mpmumau/Peabot-Library/3d_models/pibot_top.stl

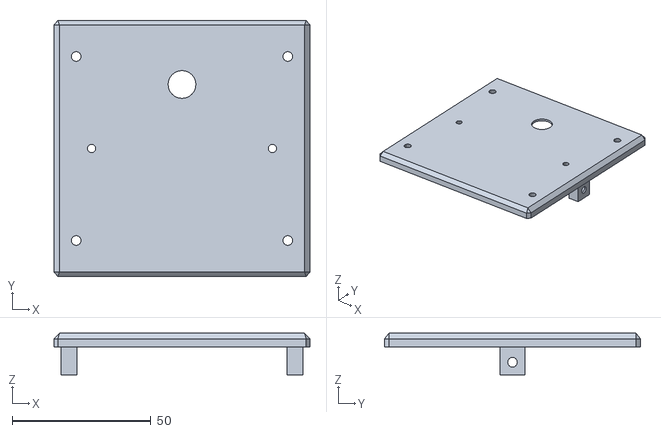
[picture p5: CAD file, 2017-05-08]
3d_models/pibot_top.stl
92.3 x 92.3 x 15.0
