mpmumau/Peabot-Library/3d_models/pibot_battery_holder_w_supports.stl

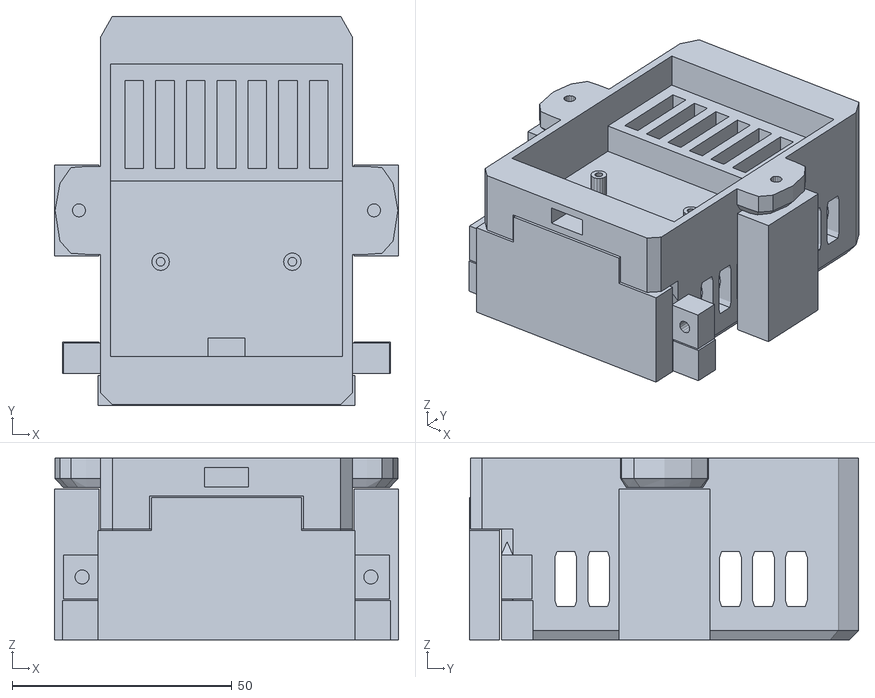
[picture p6: CAD file, 2017-05-08]
3d_models/pibot_battery_holder_w_supports.stl
78.3 x 88.6 x 41.4
