mpmumau/Peabot-Library/3d_models/pibot_battery_holder_face.stl

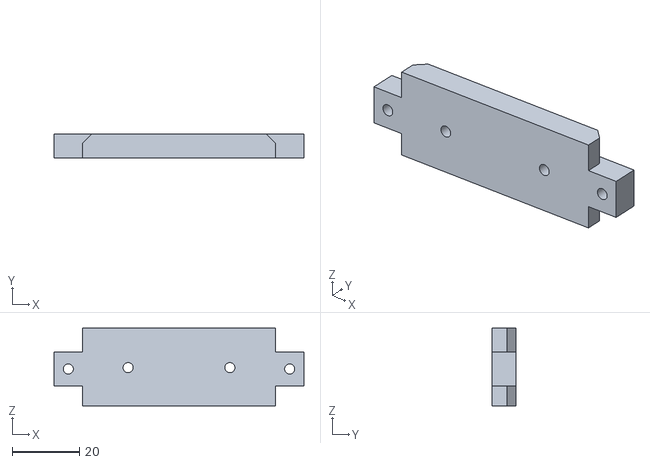
[picture p7: CAD file, 2017-05-08]
3d_models/pibot_battery_holder_face.stl
74.3 x 7.00 x 23.1
