mpmumau/Peabot-Library/3d_models/pibot_body.stl

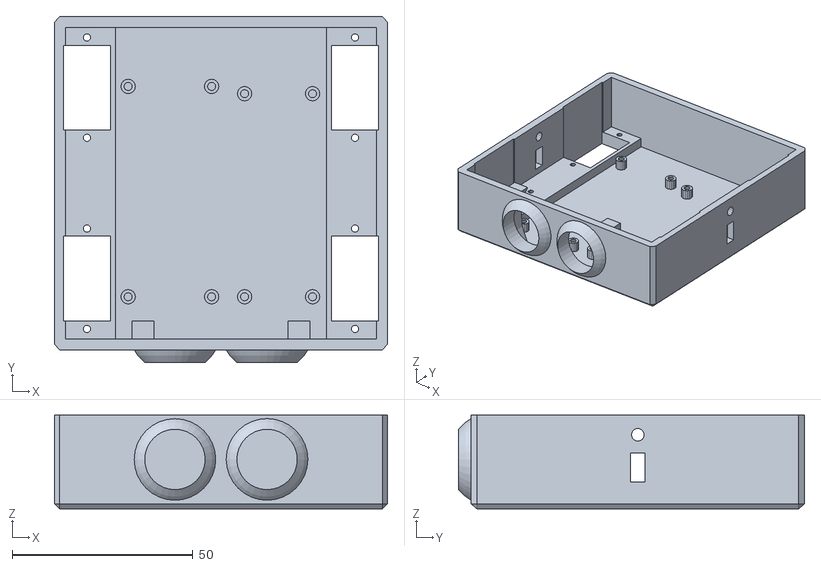
[picture p8: CAD file, 2017-05-08]
3d_models/pibot_body.stl
92.3 x 95.8 x 26.0
