mpmumau/Peabot-Library/src/config.c

#ifndef CONFIG_DEF
#define CONFIG_DEF

/*
 File:          config.c
 Description:   Implementation of config functions.
 Created:       May 8, 2017
 Author:        Matt Mumau
 */

#define _POSIX_C_SOURCE 199309L

/* System includes*/
#include <stdio.h>
#include <stdlib.h>
#include <time.h>
#include <string.h>

/* Application includes */
#include "main.h"
#include "log.h"
#include "string_utils.h"
#include "config_defaults.h"
#include "configset_callbacks.h"
#include "config_stdin.h"
#include "config_file.h"

/* Header */
#include "config.h"

/* Forward decs */
static void config_set_defaults();
static char *config_default_log_filename();
static void config_default_servo_pin_data();
static void config_default_servo_limit_data();

static Config config;

void config_init(int argc, char *argv[])
{
    config_set_defaults();

    configstdin_pipe(argc, argv);

    const char *config_file = (const char *) config_get(CONF_CONFIG_FILE);
    if (config_file)
        configfile_process((char *) config_file);
}

void config_destroy()
{
    if (config.log_filename)
        free((char *) config.log_filename);

    if (config.log_fullpath)
        free((char *) config.log_fullpath);

    if (config.servo_pins)
        free(config.servo_pins);

    if (config.servo_limits)
        free(config.servo_limits);
}

void config_set(unsigned short config_var, void *data, bool is_string)
{
    void (*config_set_callback)(Config *config, void *data, bool is_string);
    config_set_callback = NULL;

    if (config_var == CONF_LOG_FILE_DIR)
        config_set_callback = configset_log_file_dir;

    if (config_var == CONF_LOG_FILENAME) 
        config_set_callback = configset_log_filename;

    if (config_var == CONF_CONFIG_FILE) 
        config_set_callback = configset_log_configfile;    

    if (config_var == CONF_LOG_STDIN) 
        config_set_callback = configset_log_stdin; 

    if (config_var == CONF_LOG_PROMPT_COMMANDS)
        config_set_callback = configset_log_prompt_commands;

    if (config_var == CONF_LOG_EVENT_ADD) 
        config_set_callback = configset_log_event_add; 

    if (config_var == CONF_LOG_EVENT_CALLBACKS) 
        config_set_callback = configset_log_event_callbacks; 

    if (config_var == CONF_LOG_KEYFRAMES) 
        config_set_callback = configset_log_keyframes;      

    if (config_var == CONF_PCA_9685_PIN_BASE) 
        config_set_callback = configset_pca_9685_pin_base;           

    if (config_var == CONF_PCA_9685_MAX_PWM) 
        config_set_callback = configset_pca_9685_max_pwm;      

    if (config_var == CONF_PCA_9685_HERTZ) 
        config_set_callback = configset_pca_9685_hertz;           

    if (config_var == CONF_SERVOS_NUM) 
        config_set_callback = configset_servos_num;       

    if (config_var == CONF_ROBOT_TICK) 
        config_set_callback = configset_robot_tick;      

    if (config_var == CONF_TRANSITIONS_ENABLE) 
        config_set_callback = configset_transitions_enable;    

    if (config_var == CONF_TRANSITIONS_TIME) 
        config_set_callback = configset_transition_time;       

    if (config_var == CONF_SERVO_PINS) 
        config_set_callback = configset_servo_pins;  

    if (config_var == CONF_SERVO_LIMITS) 
        config_set_callback = configset_servo_limits;    

    if (config_var == CONF_WALK_HIP_DELTA) 
        config_set_callback = configset_walk_hip_delta;         

    if (config_var == CONF_WALK_KNEE_DELTA) 
        config_set_callback = configset_walk_knee_delta; 

    if (config_var == CONF_WALK_KNEE_PAD_A) 
        config_set_callback = configset_walk_knee_pad_a;         

    if (config_var == CONF_WALK_KNEE_PAD_B) 
        config_set_callback = configset_walk_knee_pad_b;     

    if (config_var == CONF_HTTP_ENABLED)
        config_set_callback = configset_http_enabled;

    if (config_var == CONF_HTTP_PORT)
        config_set_callback = configset_http_port;

    /* Callback execute */
    if (config_set_callback != NULL)
        (*config_set_callback)(&config, data, is_string);

    return;
}

void *config_get(unsigned short config_var)
{
    void *ret_val = NULL;

    if (config_var == CONF_LOG_FILE_DIR)
        ret_val = (void *) config.log_file_dir;

    if (config_var == CONF_LOG_FILENAME)
        ret_val = (void *) config.log_filename;    

    if (config_var == CONF_LOG_FULLPATH)
        ret_val = (void *) config.log_fullpath;    

    if (config_var == CONF_CONFIG_FILE)
        ret_val = (void *) config.config_file;  

    if (config_var == CONF_LOG_STDIN)
        ret_val = (void *) &(config.log_stdin);      

    if (config_var == CONF_LOG_PROMPT_COMMANDS)
        ret_val = (void *) &(config.log_prompt_commands);     
        
     if (config_var == CONF_LOG_EVENT_ADD)
        ret_val = (void *) &(config.log_event_add);  
        
     if (config_var == CONF_LOG_EVENT_CALLBACKS)
        ret_val = (void *) &(config.log_event_callbacks);   

     if (config_var == CONF_LOG_KEYFRAMES)
        ret_val = (void *) &(config.log_keyframes);       

     if (config_var == CONF_PCA_9685_PIN_BASE)
        ret_val = (void *) &(config.pca_9685_pin_base);  

     if (config_var == CONF_PCA_9685_MAX_PWM)
        ret_val = (void *) &(config.pca_9685_max_pwm);  

     if (config_var == CONF_PCA_9685_HERTZ)
        ret_val = (void *) &(config.pca_9685_hertz);

     if (config_var == CONF_SERVOS_NUM)
        ret_val = (void *) &(config.servos_num);

     if (config_var == CONF_ROBOT_TICK)
        ret_val = (void *) &(config.robot_tick);   
        
     if (config_var == CONF_TRANSITIONS_ENABLE)
        ret_val = (void *) &(config.transitions_enable);  
        
     if (config_var == CONF_TRANSITIONS_TIME)
        ret_val = (void *) &(config.transition_time);                

     if (config_var == CONF_TRANSITIONS_TIME)
        ret_val = (void *) &(config.transition_time); 

     if (config_var == CONF_SERVO_PINS)
        ret_val = (void *) config.servo_pins;       
        
     if (config_var == CONF_SERVO_LIMITS)
        ret_val = (void *) config.servo_limits;   
        
     if (config_var == CONF_WALK_HIP_DELTA)
        ret_val = (void *) &(config.walk_hip_delta);

     if (config_var == CONF_WALK_KNEE_DELTA)
        ret_val = (void *) &(config.walk_knee_delta);           

     if (config_var == CONF_WALK_KNEE_PAD_A)
        ret_val = (void *) &(config.walk_knee_pad_a);

     if (config_var == CONF_WALK_KNEE_PAD_B)
        ret_val = (void *) &(config.walk_knee_pad_b);      

     if (config_var == CONF_HTTP_ENABLED)
        ret_val = (void *) &(config.http_enabled);

     if (config_var == CONF_HTTP_PORT)
        ret_val = (void *) &(config.http_port);                                                                                                                                         

    return ret_val;
}

unsigned short config_str_to_servo_index(const char *str)
{
    if (str_starts(str, "back_left_knee"))
        return SERVO_INDEX_BACK_LEFT_KNEE;

    if (str_starts(str, "back_left_hip"))
        return SERVO_INDEX_BACK_LEFT_HIP; 

    if (str_starts(str, "front_left_knee"))
        return SERVO_INDEX_FRONT_LEFT_KNEE;  

    if (str_starts(str, "front_left_hip"))
        return SERVO_INDEX_FRONT_LEFT_HIP;

    if (str_starts(str, "back_right_knee"))
        return SERVO_INDEX_BACK_RIGHT_KNEE;

    if (str_starts(str, "back_right_hip"))
        return SERVO_INDEX_BACK_RIGHT_HIP; 

    if (str_starts(str, "front_right_knee"))
        return SERVO_INDEX_FRONT_RIGHT_KNEE;  

    if (str_starts(str, "front_right_hip"))
        return SERVO_INDEX_FRONT_RIGHT_HIP;        

    return -1;                        
}

static void config_set_defaults()
{
    const char *log_file_dir = DEFAULT_LOG_DIR;
    config_set(CONF_LOG_FILE_DIR, (void *) log_file_dir, false);
    
    const char *log_filename = config_default_log_filename();
    config_set(CONF_LOG_FILENAME, (void *) log_filename, false);

    int full_path_size = strlen(config.log_file_dir) + strlen(config.log_filename) + 1;
    config.log_fullpath = calloc(full_path_size, sizeof(char));
    if (!config.log_fullpath)
        APP_ERROR("Unable to allocate memory", 1);

    strcpy((char *) config.log_fullpath, config.log_file_dir);
    strcat((char *) config.log_fullpath, config.log_filename);

    config.config_file = NULL;

    bool log_stdin = DEFAULT_LOG_STDIN;
    config_set(CONF_LOG_STDIN, (void *) &log_stdin, false);

    bool log_prompt_commands = DEFAULT_LOG_PROMPT_COMMANDS;
    config_set(CONF_LOG_PROMPT_COMMANDS, (void *) &log_prompt_commands, false);

    bool log_event_add = DEFAULT_LOG_EVENT_ADD;
    config_set(CONF_LOG_EVENT_ADD, (void *) &log_event_add, false);

    bool log_event_callbacks = DEFAULT_LOG_EVENT_CALLBACKS;
    config_set(CONF_LOG_EVENT_CALLBACKS, (void *) &log_event_callbacks, false);

    bool log_keyframes = DEFAULT_LOG_KEYFRAMES;
    config_set(CONF_LOG_KEYFRAMES, (void *) &log_keyframes, false);

    unsigned int pca_9685_pin_base = DEFAULT_PCA_9685_PIN_BASE;
    config_set(CONF_PCA_9685_PIN_BASE, (void *) &pca_9685_pin_base, false);

    unsigned int pca_9685_max_pwm = DEFAULT_PCA_9685_MAX_PWM;
    config_set(CONF_PCA_9685_MAX_PWM, (void *) &pca_9685_max_pwm, false);

    unsigned int pca_9685_hertz = DEFAULT_PCA_9685_HERTZ;
    config_set(CONF_PCA_9685_HERTZ, (void *) &pca_9685_hertz, false);

    unsigned short servos_num = DEFAULT_SERVOS_NUM;
    config_set(CONF_SERVOS_NUM, (void *) &servos_num, false);

    double robot_tick = DEFAULT_ROBOT_TICK;
    config_set(CONF_ROBOT_TICK, (void *) &robot_tick, false);

    bool transitions_enable = DEFAULT_TRANSITIONS_ENABLE;
    config_set(CONF_TRANSITIONS_ENABLE, (void *) &transitions_enable, false);

    double transitions_time = DEFAULT_KEYFRAME_TRANSITION_TIME;
    config_set(CONF_TRANSITIONS_TIME, (void *) &transitions_time, false);

    double walk_hip_delta = DEFAULT_HIP_DELTA;
    config_set(CONF_WALK_HIP_DELTA, (void *) &walk_hip_delta, false);

    double walk_knee_delta = DEFAULT_KNEE_DELTA;
    config_set(CONF_WALK_KNEE_DELTA, (void *) &walk_knee_delta, false);

    double walk_knee_pad_a = DEFAULT_KNEE_PAD_A;
    config_set(CONF_WALK_KNEE_PAD_A, (void *) &walk_knee_pad_a, false);

    double walk_knee_pad_b = DEFAULT_KNEE_PAD_B;
    config_set(CONF_WALK_KNEE_PAD_B, (void *) &walk_knee_pad_b, false);

    bool http_enabled = DEFAULT_HTTP_ENABLED;
    config_set(CONF_HTTP_ENABLED, (void *) &http_enabled, false);

    unsigned short http_port = DEFAULT_HTTP_PORT;
    config_set(CONF_HTTP_PORT, (void *) &http_port, false);

    // Do these after processing other configs; dependent upon them.
    config.servo_pins = calloc(config.servos_num, sizeof(unsigned short));
    if (!config.servo_pins)
        APP_ERROR("Unable to allocate memory.", 1);

    config_default_servo_pin_data();

    config.servo_limits = calloc(config.servos_num, sizeof(ServoLimit));
    if (!config.servo_pins)
        APP_ERROR("Unable to allocate memory.", 1);
    config_default_servo_limit_data();
}

static void config_default_servo_pin_data()
{
    ServoPinData servo_pin_data;
    unsigned short num;
    
    for (unsigned short i = 0; i < config.servos_num; i++)
    {  
        switch (i)
        {
            case SERVO_INDEX_BACK_LEFT_KNEE:
                num = DEFAULT_BACK_LEFT_KNEE;
                break;
            case SERVO_INDEX_BACK_LEFT_HIP:
                num = DEFAULT_BACK_LEFT_HIP;
                break;
            case SERVO_INDEX_FRONT_LEFT_KNEE:
                num = DEFAULT_FRONT_LEFT_KNEE;
                break;                
            case SERVO_INDEX_FRONT_LEFT_HIP:
                num = DEFAULT_FRONT_LEFT_HIP;
                break;
            case SERVO_INDEX_BACK_RIGHT_KNEE:
                num = DEFAULT_BACK_RIGHT_KNEE;
                break;
            case SERVO_INDEX_BACK_RIGHT_HIP:
                num = DEFAULT_BACK_RIGHT_HIP;
                break;
            case SERVO_INDEX_FRONT_RIGHT_KNEE:
                num = DEFAULT_FRONT_RIGHT_KNEE;
                break;     
            case SERVO_INDEX_FRONT_RIGHT_HIP:
                num = DEFAULT_FRONT_RIGHT_HIP;
                break;       
            default:
                continue;       
        }

        servo_pin_data.id = i;
        servo_pin_data.val = num;
        config_set(CONF_SERVO_PINS, (void *) &servo_pin_data, false);
    }    
}

static void config_default_servo_limit_data()
{    
    ServoLimitData servo_limit_data;

    for (unsigned short j = 0; j < config.servos_num; j++)
    {
        servo_limit_data.id = j;
        servo_limit_data.min = DEFAULT_SERVO_MIN;
        servo_limit_data.max = DEFAULT_SERVO_MAX;

        config_set(CONF_SERVO_LIMITS, (void *) &servo_limit_data, false);
    }
}

static char *config_default_log_filename()
{
    char *filename = calloc(LOG_FILENAME_MAXLEN, sizeof(char));

    time_t current_time = time(NULL);
    struct tm *ltime = localtime(&current_time);

    snprintf(filename, LOG_FILENAME_MAXLEN, 
        "peabot.%.*d-%.*d-%.*d_%.*d-%.*d-%.*d.log", 
        2,
        ltime->tm_mon, 
        2,
        ltime->tm_mday, 
        2,
        ltime->tm_year % 100, 
        2,
        ltime->tm_hour, 
        2,
        ltime->tm_min, 
        2,
        ltime->tm_sec);  

    return filename;
}

#endif
