mpmumau/Peabot-Library/src/movements.c

#ifndef MOVEMENTS_DEF
#define MOVEMENTS_DEF

/*
 File:          movements.c
 Description:   Implementation of a data structure and utility functions for servo sweeps.
 Created:       May 8, 2017
 Author:        Matt Mumau
 */

/* System includes*/
#include <stdlib.h>

/* Application includes */
#include "config.h"

#include "movements.h"

Keyframe mvmt_walk_a[SERVOS_NUM] = {
    { -0.7f, 0.7f, 0.0f },
    { -0.7f, 0.7f, 0.0f },
    {  0.7f, -0.7f, 0.0f },
    { -0.2f, 0.2f, 0.0f },
    { -0.2f, 0.2f, 0.0f },
    { -0.2f, 0.2f, 0.0f },
    { -0.2f, 0.2f, 0.0f },    
    { -0.2f, 0.2f, 0.0f }
};

Keyframe mvmt_up[SERVOS_NUM] = {
    { -1.0, 1.0, 0.0f },
    {},
    {},
    { -1.0, 1.0, 0.0f },
    { -1.0, 1.0, 0.0f },
    {},
    { -1.0, 1.0, 0.0f },
    {}
};

#endif
