mpmumau/Peabot-Library/inc/log.h

#ifndef LOG_H_DEF
#define LOG_H_DEF

/*
 File:          log.h
 Description:   Utility functions used for dealing with a log file.
 Created:       May 5, 2017
 Author:        Matt Mumau
 */

#define LOG_LINE_LEN 512
#define LOG_CACHE_SIZE 1024

/* Open the given log file for appending. */
void log_init();

/* Write the given line to the log file. */
void log_write(char *line);

/* Close the log file. */
void log_close();

/* Write a header line in the log file, surrounded by double line breaks. */
void log_h(char *val);

/* Write a single line break to the log. */
void log_br();

/* Write the given data to the log, which will be prepended by a timestamp. */
void log_event(const char *msg);

/* Log the message and tag it as an error in the log file. */
void log_error(const char *msg, int error_code);

/* Get the log messages in the log cache, and reset the cache. */
int log_get_cache(char (*lines)[LOG_LINE_LEN], int start);

#endif
