mpmumau/Peabot-Library/inc/http_request_handler.h

#ifndef HTTP_REQUEST_HANDLER_H_DEF
#define HTTP_REQUEST_HANDLER_H_DEF

/*
 File:          http_request_handler.h
 Description:   Handler functions for HTTP requests.
 Created:       May 28, 2017
 Author:        Matt Mumau
 */


void *httprhnd_handle_request(void *data);

#endif
