mpmumau/Peabot-Library/(commit log)

2017-05-08 Fixed some exit codes
    [main.c, robot.c]
2017-05-08 Attempting to fix quit command
    [prompt.c]
2017-05-08 Removed pthread_cancel, replaced with pthread_join
    [prompt.c, robot.c]
2017-05-08 Fixing program flow
2017-05-08 Added null returns to threads
2017-05-08 Fixed list pop function
    [list.c]
2017-05-09 Changed timers to pointers
2017-05-09 Testing servo movements
2017-05-09 Renamed servo_mvmt to Keyframe
2017-05-09 Another fix to the delay command
    [prompt.c]
2017-05-09 Fix on missing type
    [prompt.c]
2017-05-09 Fixed prompt if statements
    [prompt.c]
2017-05-09 Fixed missing & operand
    [prompt.c]
2017-05-09 Fixed missing type specifiers
    [prompt.c]
2017-05-09 Fixed param num for srv function
    [prompt.c]
2017-05-09 Misc fixes re args_num in prompt callbacks
    [prompt.c]
2017-05-10 Refactored ServoRange to ServoLimit; added function to get serovo val
2017-05-11 Added proper reset event
    [prompt_commands.c]
2017-05-12 Fixed defs in keyframe_handler
    [keyframe_handler.h]
2017-05-12 Syntax error in keyframe handler
    [config.h, keyframe_handler.h]
2017-05-12 Fixed setting event callback function to null
    [events.c]
2017-05-12 Changed method of assigning servopos
2017-05-12 Attempt at fixing servopos
    [keyframe_factory.c]
2017-05-12 Added reset and delay event callback logging
    [config.h, event_callbacks.c]
2017-05-12 Reset event callback logging
    [prompt_commands.c]
2017-05-12 Fixed easing function when negative
    [easing.c]
2017-05-13 Attempt at fixing walk animation
    [keyframe_factory.c]
2017-05-15 Testing method of flipping in walk animation
    [keyframe_factory.c]
2017-05-15 Added ability to set beginning and end padding to individual ServoPos elements
2017-05-15 Fixed my math for padding
    [keyframe_handler.c]
2017-05-15 Fixing walk keyframe factory
    [keyframe_factory.c]
2017-05-15 more fixes to walk
    [keyframe_factory.c]
2017-05-15 Fixed ServoPos var name
    [keyframe_factory.c]
2017-05-15 New method of moving legs during walk
2017-05-15 Testing swap of knee vals
    [keyframe_factory.c]
2017-05-15 Swap till you drop
    [keyframe_factory.c]
2017-05-15 Added skip_transitions param to keyhandler_add; ensure walk disables transitions
    [event_callbacks.c, keyframe_handler.c, keyframe_handler.h]
2017-05-15 Fixed padding offset time calc
    [keyframe_handler.c]
2017-05-15 One more logging fix
    [keyframe_handler.c]
2017-05-15 Fixed flow
2017-05-17 Fixed void pointer param syntax in config callback functions
    [config_callbacks.h]
2017-05-17 Missing semicolon in config.c
    [config.c]
2017-05-17 Fixed void pointer syntax
    [config.c]
2017-05-17 Fixed callback variable signature
    [config.c]
2017-05-17 Fixed config_set callback signatures to take Config pointer
    [config.c]
2017-05-17 Fixed config_callback function decs
    [config_callbacks.h]
2017-05-17 Fixed dec for config_get function
    [config.h]
2017-05-17 Fixed generation of log filename
    [config.c]
2017-05-17 Initializing servo array for robot on stack
2017-05-17 Attempt at syntax fix
    [robot.c]
2017-05-17 Fixed servo reference
2017-05-17 Reorganized robot mv joint function
2017-05-17 Fixed inv check pin defines
    [robot.c]
2017-05-17 Fixed keyframe factory define references
    [keyframe_factory.c]
2017-05-17 Fixed servo limit config callback
2017-05-18 Using abstracted defines to set servo pins
2017-05-18 Fixed inverse servos
2017-05-18 Attempting to fix incorrect pin assignments
    [keyframe_handler.c, robot.c]
2017-05-18 Fixed compile time define
    [config.c]
2017-05-18 Fixed various file handle references
    [config.c]
2017-05-18 Fix for config file config_set call
    [config.c, config_callbacks.h]
2017-05-18 Fixed config file callback name
    [config.c]
2017-05-19 Added missing print variable
    [prompt_commands.c]
2017-05-19 Commit case where index is greater than servos_num
2017-05-19 Missing file pointer param
    [config_file.c]
2017-05-19 Fixed config_file param name
    [config_file.c]
2017-05-19 Fixed name of function call
    [config_file.c]
2017-05-19 Fixed incorrect OR signs
    [config_file.c]
2017-05-19 Fixed missing params for config_set call
    [config_file.c]
2017-05-19 Close application if wrong config file given
    [config_file.c]
2017-05-20 Added missing keyframe_handler for extend
    [keyframe_handler.c]
2017-05-20 Fixed transitions for reset event
    [event_callbacks.c, log.c]
2017-05-20 Fixed a few things
    [event_callbacks.c]
2017-05-20 Fix mallocs->callocs in event_callbacks.c
    [event_callbacks.c]
2017-05-21 Potential fix for last keyframe problem
    [keyframe_factory.c, keyframe_handler.c]
2017-05-21 Another attempt at a fix for the last keyframe problem
    [keyframe_handler.c]
2017-05-25 Rough skeleton of usd sensor object
2017-06-02 Added reset to end of walk
    [event_callbacks.c]
2017-06-06 Added reset to halt event
    [event_callbacks.c]
2017-06-09 Reset PCA9685 on robot_halt
    [robot.c]
2017-06-10 Rough buzzer object definition
    [buzzer.c, buzzer.h, main.c]
2017-06-12 Commented out the buzzer
    [main.c]
