mpmumau/Peabot-Library/(notices)

Notices in the files:
src/easing.c:
To Public License, Version 2, as published by Sam Hocevar. See
http://sam.zoy.org/wtfpl/COPYING for more details.
